ottingerg/lecroy_mfp415/frontpanel.sch

## KiCad design frontpanel.sch (2020-12-30)

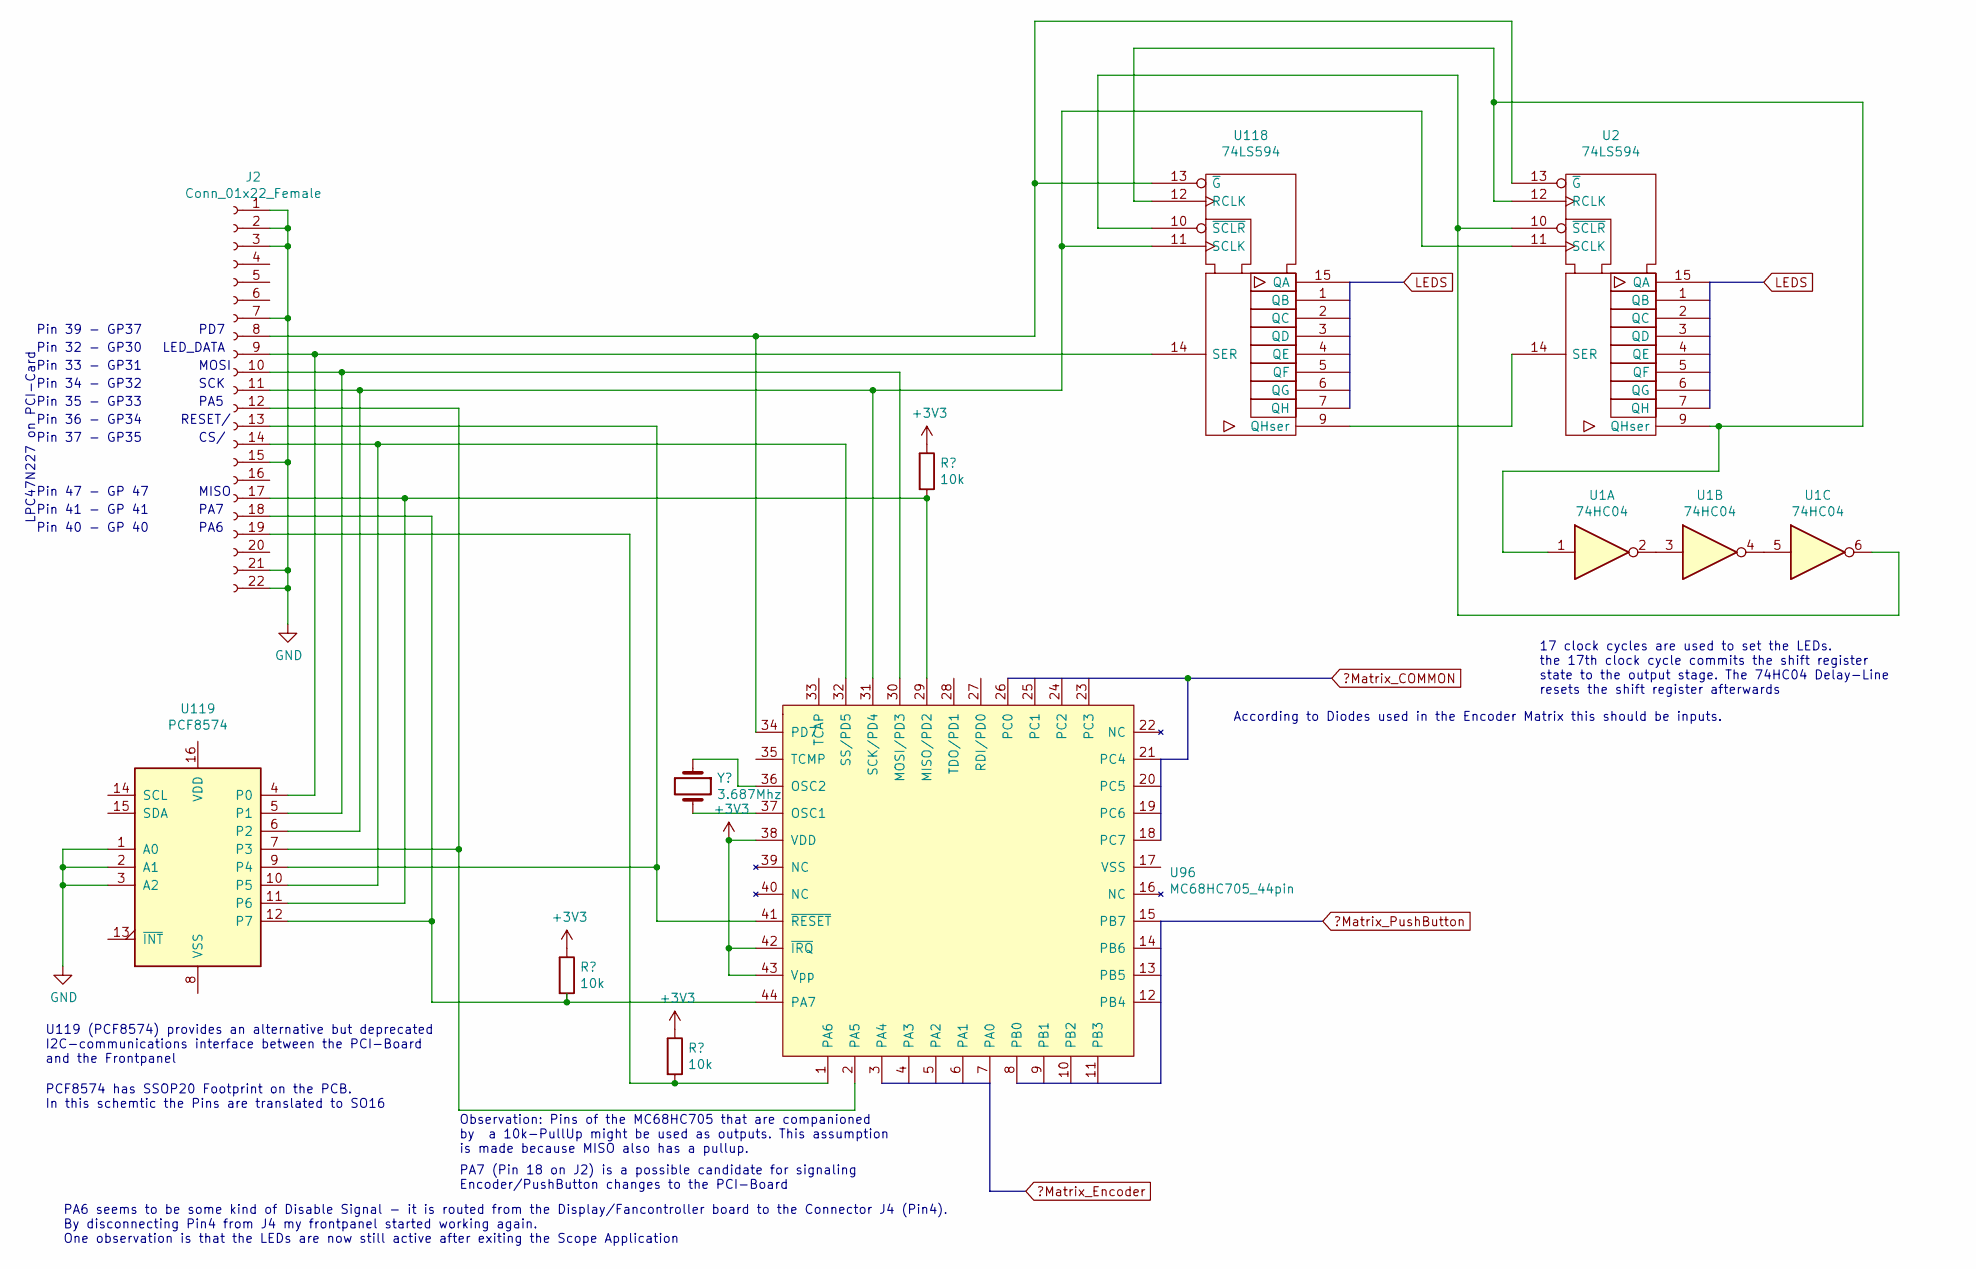
[picture p1: schematic frontpanel.sch]

Parts:
J2: Conn_01x22_Female
U1: 74HC04
U2, U118: 74LS594
U96: MC68HC705_44pin
U119: PCF8574

Connections:
+3V3: U96.38 (VDD), U96.42 (~IRQ), U96.43 (Vpp)
GND: J2.1, J2.2, J2.3, J2.7, J2.15, J2.21, J2.22, U119.1 (A0), U119.2 (A1), U119.3 (A2)
unnamed: J2.8, U2.13 (~G), U96.34 (PD7), U118.13 (~G)
unnamed: J2.9, U118.14 (SER), U119.4 (P0)
unnamed: J2.10, U96.30 (MOSI/PD3), U119.5 (P1)
unnamed: J2.11, U2.11 (SCLK), U96.31 (SCK/PD4), U118.11 (SCLK), U119.6 (P2)
unnamed: J2.12, U96.2 (PA5), U119.7 (P3)
unnamed: J2.13, U96.41 (~RESET), U119.9 (P4)
unnamed: J2.14, U96.32 (SS/PD5), U119.10 (P5)
unnamed: J2.17, U96.29 (MISO/PD2), U119.11 (P6)
unnamed: J2.18, U96.44 (PA7), U119.12 (P7)
unnamed: J2.19, U96.1 (PA6)
unnamed: U1.1, U2.9 (QHser), U2.12 (RCLK), U118.12 (RCLK)
unnamed: U1.2, U1.3
unnamed: U1.4, U1.5
unnamed: U1.6, U2.10 (~SCLR), U118.10 (~SCLR)
unnamed: U2.14 (SER), U118.9 (QHser)

Notes on the sheet:
PCF8574 has SSOP20 Footprint on the PCB. In this schemtic the Pins are translated to SO16
U119 (PCF8574) provides an alternative but deprecated I2C-communications interface between the PCI-Board and the Frontpanel
PA7 (Pin 18 on J2) is a possible candidate for signaling Encoder/PushButton changes to the PCI-Board
Observation: Pins of the MC68HC705 that are companioned by a 10k-PullUp might be used as outputs. This assumption is made because MISO also has a pullup.
17 clock cycles are used to set the LEDs. the 17th clock cycle commits the shift register state to the output stage. The 74HC04 Delay-Line resets the shift register afterwards
MISO
MOSI
SCK
CS/
RESET/
PA7
PD7
PA6
According to Diodes used in the Encoder Matrix this should be inputs.
PA5
LED_DATA
Pin 32 - GP30
Pin 33 - GP31
Pin 34 - GP32
Pin 35 - GP33
Pin 36 - GP34
Pin 37 - GP35
Pin 47 - GP 47
Pin 41 - GP 41
Pin 40 - GP 40
LPC47N227 on PCI-Card
Pin 39 - GP37
PA6 seems to be some kind of Disable Signal - it is routed from the Display/Fancontroller board to the Connector J4 (Pin4). By disconnecting Pin4 from J4 my frontpanel started working again. One observation is that the LEDs are now still active after exiting the Scope Application
