ottingerg/lecroy_mfp415/Frontpanel-Fix-schema.png

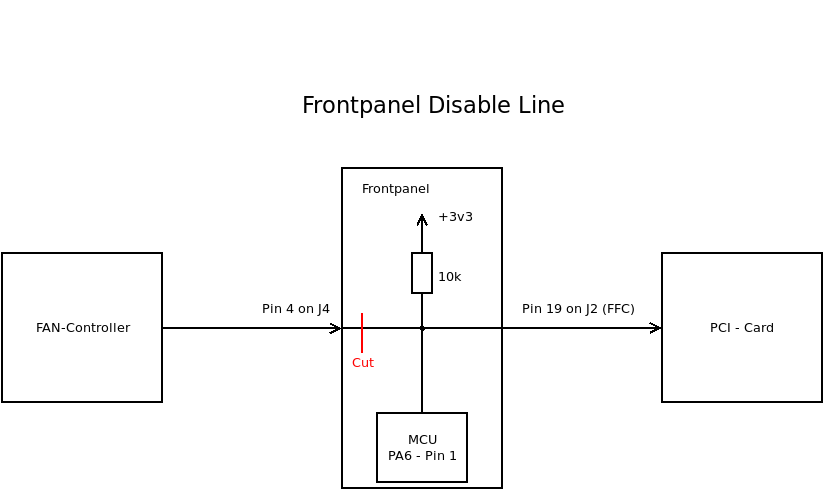
Frontpanel-Fix-schema.png
