ottingerg/lecroy_mfp415/(commit log)

2020-10-30 added 100tqfp 0.4 to 0.5 pitch adapter
    [frontpanel.kicad_pcb]
2020-11-02 modified adapter
    [frontpanel.kicad_pcb]
2020-12-11 some labeling
    [frontpanel.sch]
2020-12-11 added crystal
    [frontpanel.sch]
2020-12-19 some annotations
    [frontpanel.sch]
2020-12-22 added connection diagram to LPC47N227
    [frontpanel.sch]
2020-12-23 added PA7 connection
    [frontpanel.sch]
2020-12-30 pa6 is some kind of disable signal
    [frontpanel.sch]
2021-01-01 Doku for Fix
    [frontpanel.kicad_pcb]
